StormOnSteroids/arm-e/cad/ARM-E V2.stl

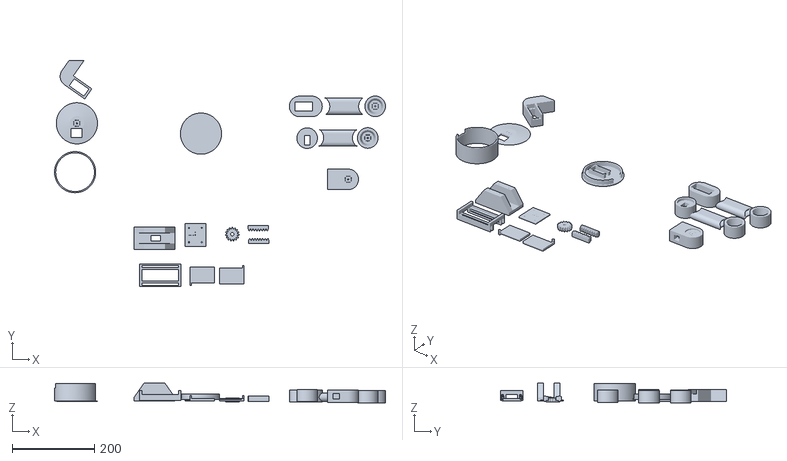
[picture p1: CAD file, 2026-11-07]
cad/ARM-E V2.stl
803.7 x 549.8 x 47.6
