StormOnSteroids/arm-e/cad/ARM-E V1.stl

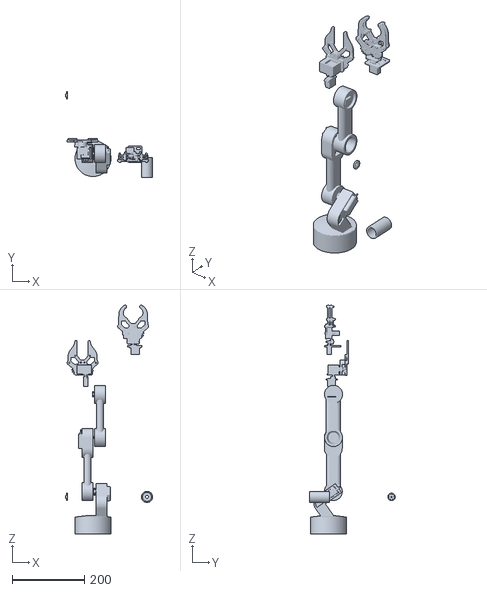
[picture p2: CAD file, 2026-11-07, an earlier design]
cad/ARM-E V1.stl
242.1 x 237.5 x 635.7
